nanase/japarimeter/docs/updates.md

---
layout: default
title: JapariMeter 更新履歴

header_top: false

subpages:
  - title: 頒布情報
    page: distribution
  - title: 更新履歴
    page: updates
---

# 更新履歴

## ファームウェア

<table class="spec-table">
  <tbody>
    <tr>
      <th>
        2021.03.21<br />
        <span class="foot-note">1.1.0 for Rev.1</span>
      </th>
      <td>
        <p>
          <a href="https://github.com/nanase/japarimeter/releases/tag/v1.1.0" target="_blank">ソース・ダウンロード</a>
        </p>
        <p>
          <ul>
            <li>
              不快指数の文字位置と表示画像を差し替えました。(thanks <a href="https://twitter.com/kachin397" target="_blank">@kachin397</a>)
            </li>
            <li>
              ページ切り替えボタンを素早く連続で押すと画面が乱れて表示されてしまう問題を修正しました。
            </li>
            <li>
              ボタンの効きが悪い問題を修正しました。
            </li>
            <li>
              バイナリファイルのサイズを削減しました。
            </li>
          </ul>
        </p>
      </td>
    </tr>
    <tr>
      <th>
        2021.01.01<br />
        <span class="foot-note">1.0.0 for Rev.1</span>
      </th>
      <td>
        <p>
          <a href="https://github.com/nanase/japarimeter/releases/tag/v1.0.0" target="_blank">ソース・ダウンロード</a>
        </p>
        <p>
          公開
        </p>
      </td>
    </tr>
  </tbody>
</table>

## 基板

<table class="spec-table">
  <tbody>
    <tr>
      <th>
        2021.01.01<br />
        <span class="foot-note">Rev.1</span>
      </th>
      <td>
        <div>公開</div>
        <div class="no-image-border text-center">
          <div class="inline-block">
            <a href="{{site.baseurl}}/assets/pdf/rev1_circuit.pdf" target="_blank">
              <br />
              回路図
            </a>
          </div>
          <div class="inline-block">
            <a href="{{site.baseurl}}/assets/pdf/rev1_pcb_top.pdf" target="_blank">
              <br />
              基板表面
            </a>
          </div>
          <div class="inline-block">
            <a href="{{site.baseurl}}/assets/pdf/rev1_pcb_bottom.pdf" target="_blank">
              <br />
              基板裏面
            </a>
          </div>
        </div>
      </td>
    </tr>
  </tbody>
</table>
