nanase/japarimeter/docs/assets/img/title/rev1.jpg

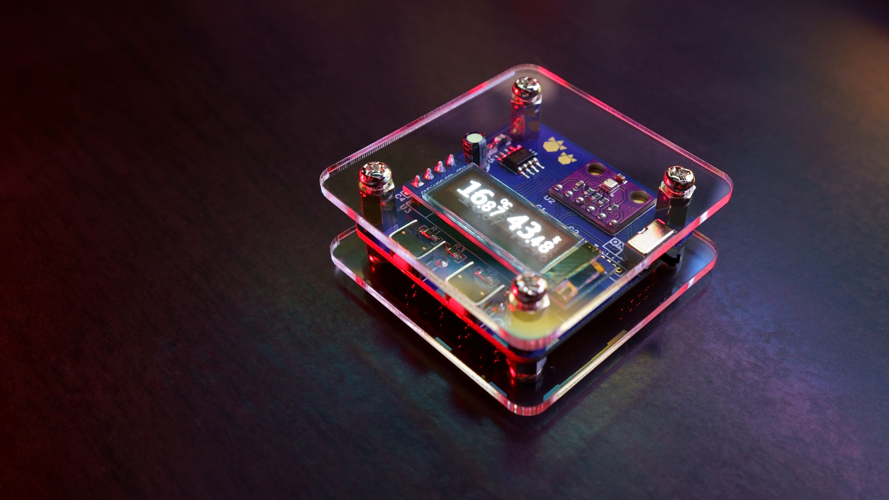
docs/assets/img/title/rev1.jpg
