nanase/japarimeter/docs/assets/pdf/rev1_parts_list.pdf

リファレンス 部品名 | 形式・値 | 型番 | 数量 | 注記 | 入手先 | 購入先リンク（参考）
| JapariMeter 基板 | | | 1
U1 | MCU | | STM32G031J6M6 | 1 | | 秋月電子 | https://akizukidenshi.com/catalog/g/gI-15688/
U2 | BME280 | 3.3V | BME280-3.3V | 1 | *1
U3 | OLED ディスプレイ | | 128x32 I2C 0.91" OLED Display | 1
B1 | ボタン電池取付用ホルダ | CR2032用 | BC-2001 | 1 | | 秋月電子 | https://akizukidenshi.com/catalog/g/gP-06925/
C1-4 | 積層セラミックコンデンサ | 1μF 2012 | EMK212BJ105KG | 4 | | 秋月電子 | https://akizukidenshi.com/catalog/g/gP-09174/
C5 | 電解コンデンサ | 10μF 16V | 16MH710MEFC4X7 | 1 | | 秋月電子 | https://akizukidenshi.com/catalog/g/gP-10591/
R1-2 | 炭素皮膜抵抗 | 10kΩ 2012 | RK73B2ATTD103J | 2 | | 千石電商 | https://www.sengoku.co.jp/mod/sgk_cart/detail.php?code=EEHD-57CE
R3-4 | 炭素皮膜抵抗 | 470Ω 1608 | RC0603J470R | 2 | *2 | 秋月電子 | https://akizukidenshi.com/catalog/g/gR-06471/
SW1-2 | 横型タクトスイッチ | | THBP07-043CW | 2 | | 秋月電子 | https://akizukidenshi.com/catalog/g/gP-14890/
SW3 | 横型スライドスイッチ | | SK-12D11VG3 | 1 | | 秋月電子 | https://akizukidenshi.com/catalog/g/gP-15703/
| 電池 | CR2032 | | 1 | | 秋月電子 | https://akizukidenshi.com/catalog/g/gB-05694/
| アクリルパネル | 45基板タイプ | LPM001T2-45 | 2 | | 秋月電子 | https://akizukidenshi.com/catalog/g/gP-12443/
| ビス | M3 | | 8
| 黄銅スペーサ | メス・メス 7mm | | 4
| 黄銅スペーサ | オス・メス 5mm | | 4

*1 5V版は取付不可。BMP280版は取り付け可能だがソフトウェア未対応
| *2 2012サイズも取付可能
