nanase/japarimeter/(threads)

Thread 1 (2021-03-21):

ボタン押下時に画面が乱れる

nanase, 2021-03-21:
## 背景

ページ送りボタンを素早く押すと画面の表示が乱れることがあり、これを修正したい。容易に再現可能。

画面の（再）描画を割り込み処理内で行っており、これが原因である可能性が高い。

## 解決方針

JapariRadio側で [`Button` クラス](https://github.com/nanase/japariradio/commit/d0f8b73d4aa98fb3d281d08c9a17077db5184c02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) を導入すると画面描画ロジックを割り込み関数から `loop` 関数に移動でき、解決できる可能性が高い。ボタン押下の判定ロジックも改良できる。

### デメリット

バイナリサイズが増加する。ただし最適化オプションを -Og から -Os に切り替え、デバッグオプションも外すと、LTOなしでもある程度は容量の余裕がある見込み。

Closed 2021-03-21.
