nanase/japarimeter/docs/assets/pdf/rev1_circuit.pdf

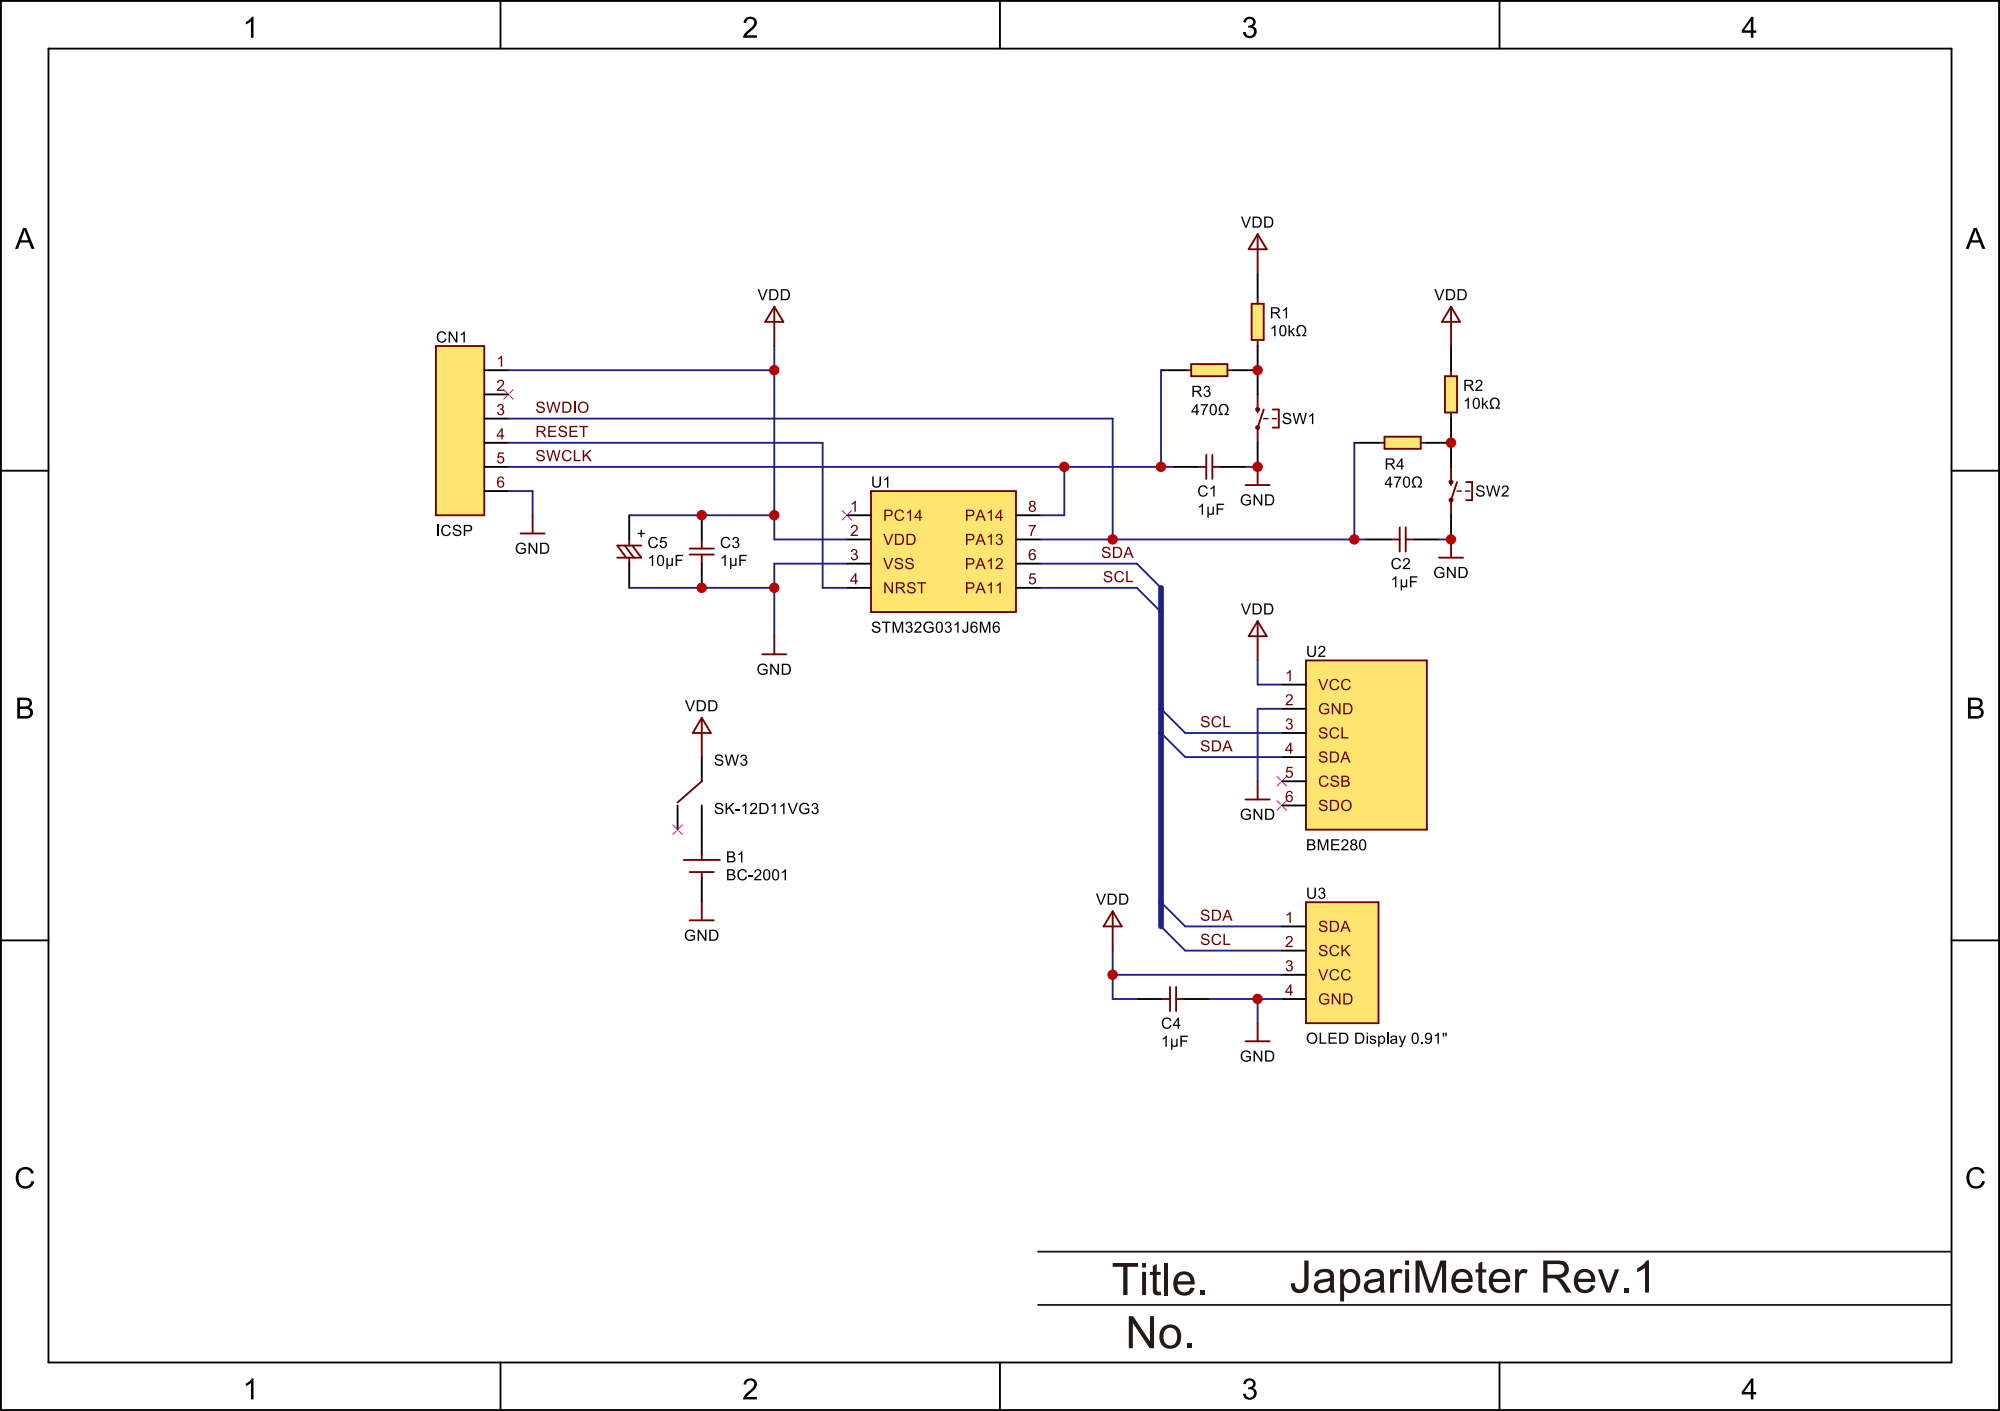
[picture p8: page 1]
