nanase/japarimeter/docs/assets/pdf/rev1_pcb_bottom.pdf

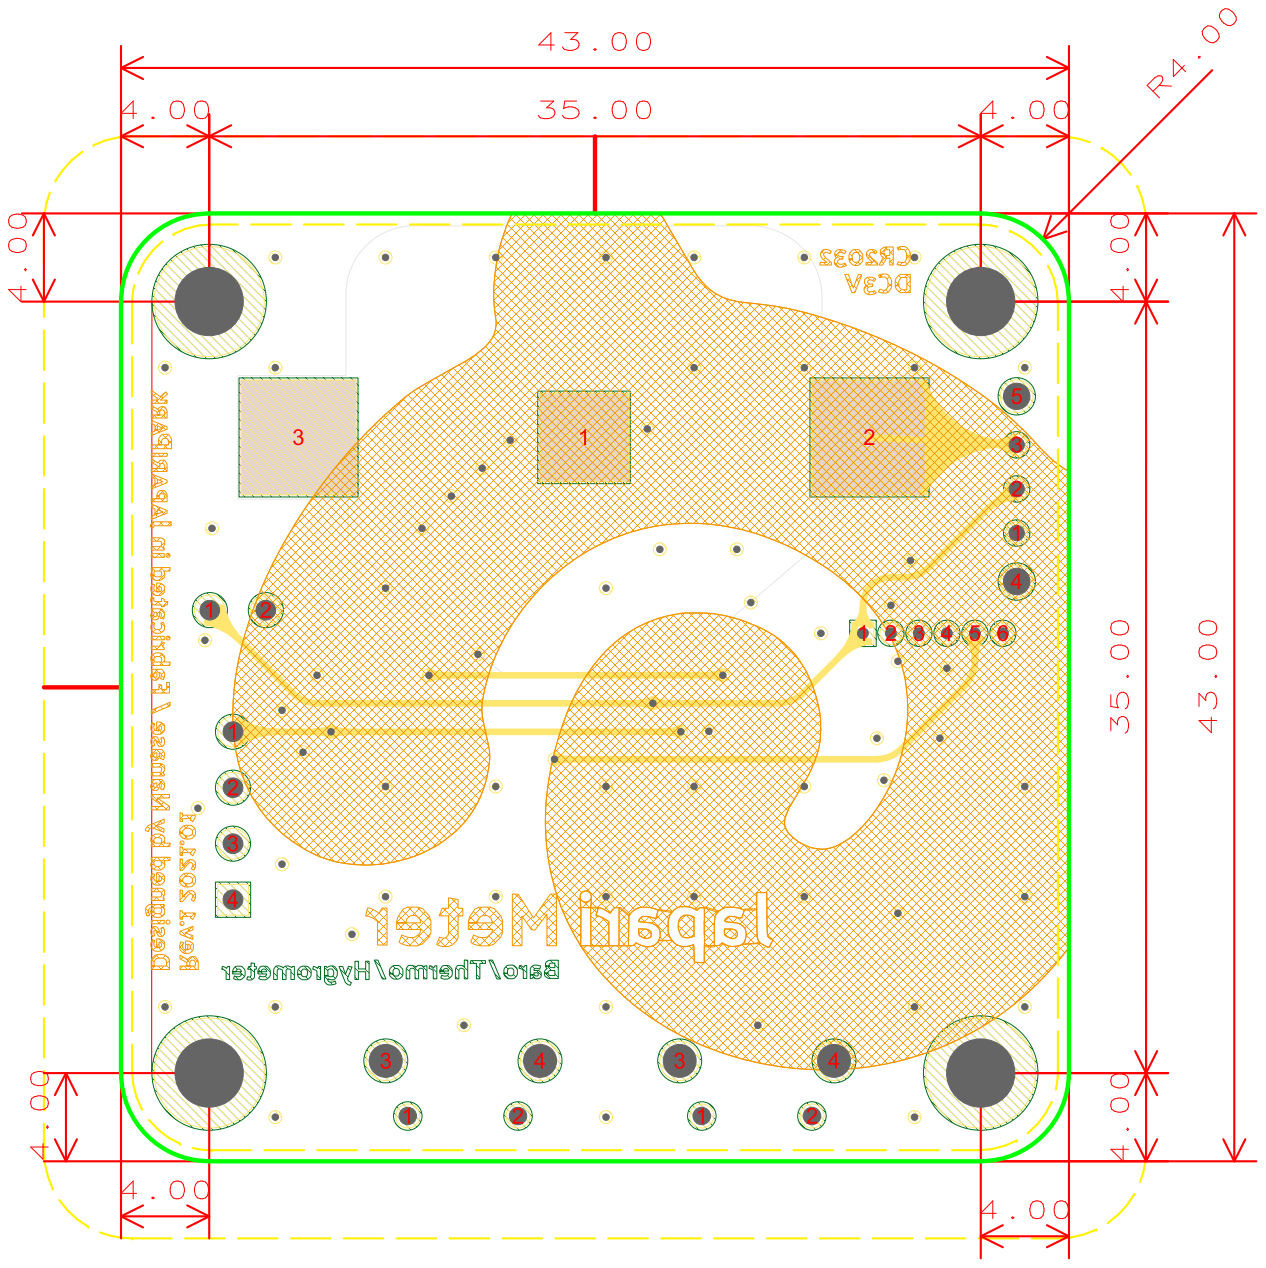
[picture p9: page 1]
