nanase/japarimeter/docs/assets/pdf/rev1_pcb_top.pdf

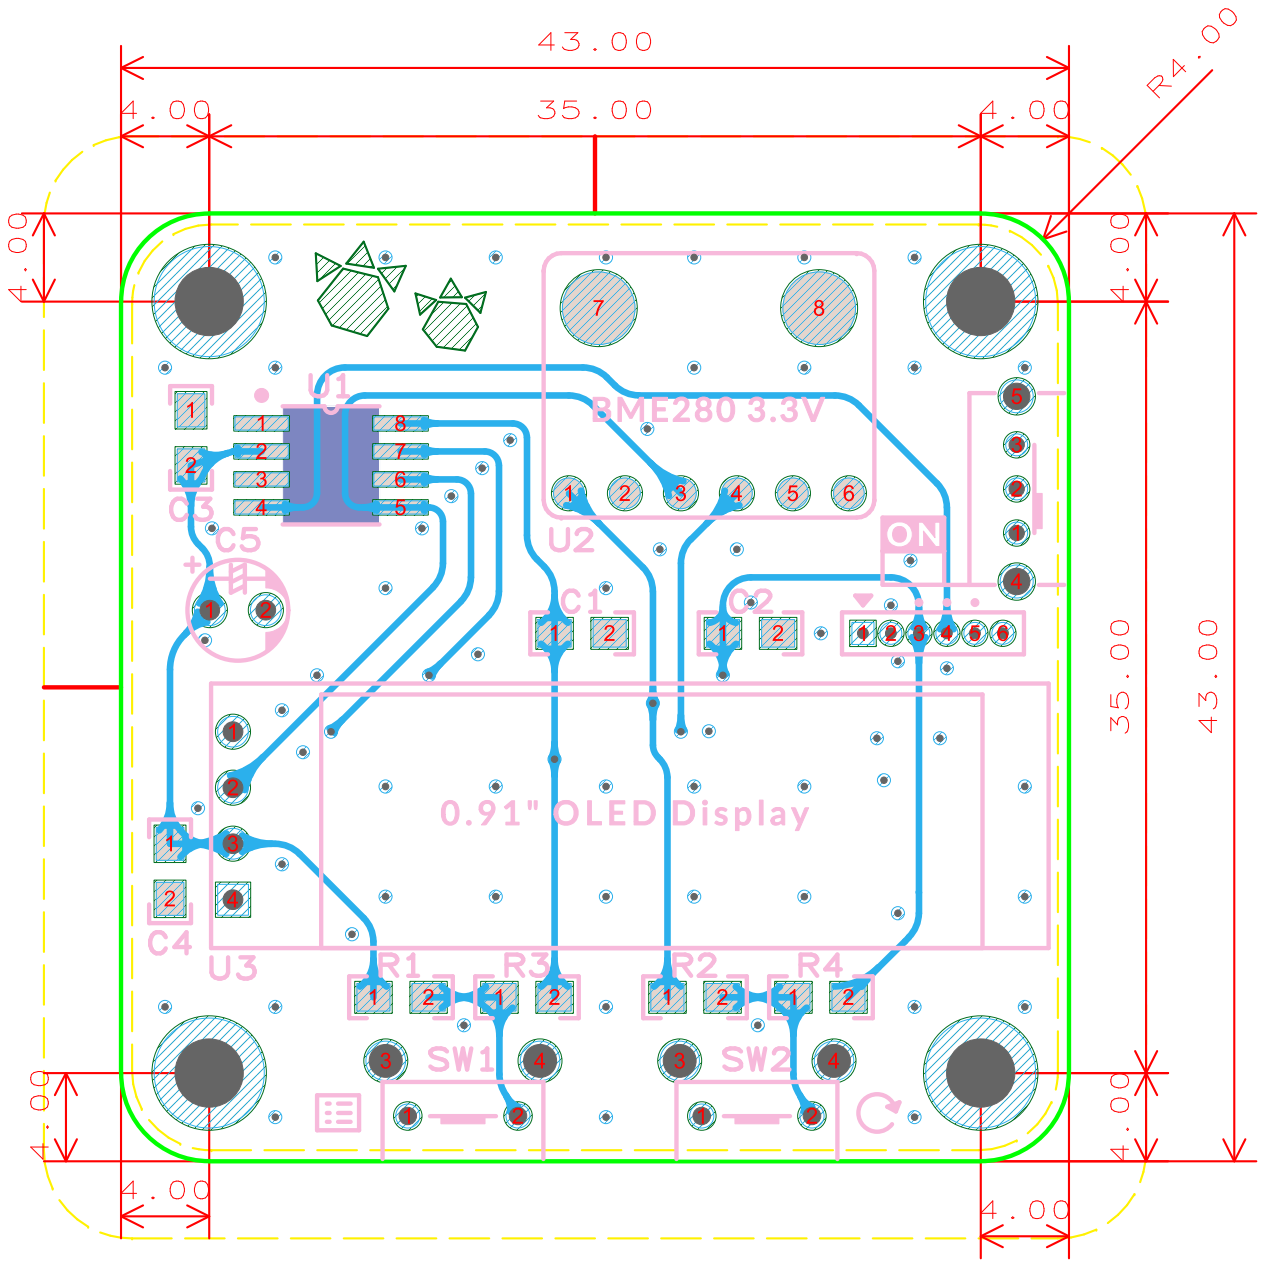
[picture p10: page 1]
