nanase/japarimeter/Inc/main.h

#define BUTTON0_Pin GPIO_PIN_0
#define BUTTON0_GPIO_Port GPIOA
#define BUTTON0_EXTI_IRQn EXTI0_IRQn
#define BUTTON1_Pin GPIO_PIN_1
#define BUTTON1_GPIO_Port GPIOA
#define BUTTON1_EXTI_IRQn EXTI1_IRQn
#define SWDIO_Pin GPIO_PIN_13
#define SWDIO_GPIO_Port GPIOA
#define SWCLK_Pin GPIO_PIN_14
#define SWCLK_GPIO_Port GPIOA
#define I2C_SCL_Pin GPIO_PIN_6
#define I2C_SCL_GPIO_Port GPIOB
#define I2C_SDA_Pin GPIO_PIN_7
#define I2C_SDA_GPIO_Port GPIOB
