nanase/japarimeter/Src/observer.c

#include "main.h"

#include "bmp280.h"
#include "ssd1306.h"
#include "fonts.h"

#include "flash.h"
#include "board_config.h"

BMP280_HandleTypedef bmp280;
char buf[32];
const uint8_t contrasts[5] = {0x01, 0x10, 0x20, 0x40, 0x8f};
uint8_t contrast_index = 4;
uint8_t page_index = 0;
float pressure, temperature, humidity;

volatile uint32_t button0_tick = 0;
volatile uint32_t button1_tick = 0;
volatile GPIO_PinState button0_state = GPIO_PIN_SET;
volatile GPIO_PinState button1_state = GPIO_PIN_SET;

extern TIM_HandleTypeDef htim6;

void HAL_TIM_PeriodElapsedCallback(TIM_HandleTypeDef *htim)
{
  if (!bmp280_read_float(&bmp280, &temperature, &pressure, &humidity))
    Error_Handler();
}

void HAL_GPIO_EXTI_Callback(uint16_t GPIO_Pin)
{
  uint32_t tick = HAL_GetTick();
  GPIO_PinState state = HAL_GPIO_ReadPin(GPIO_Pin == BUTTON0_Pin ? BUTTON0_GPIO_Port : BUTTON1_GPIO_Port, GPIO_Pin);

  if (GPIO_Pin == BUTTON0_Pin)
  {
    if (tick - button0_tick >= 200)
    {
      if (!state && page_index < 1)
        page_index++;

      button0_state = state;
    }

    button0_tick = tick;
  }

  if (GPIO_Pin == BUTTON1_Pin)
  {
    if (tick - button1_tick >= 200)
    {
      if (!state && page_index > 0)
        page_index--;

      button1_state = state;
    }

    button1_tick = tick;
  }
}

void setup()
{
  bmp280_init_default_params(&bmp280.params);
  bmp280.addr = BMP280_I2C_ADDRESS_0;
  bmp280.i2c = &hi2c1;
  // bmp280.params.mode = BMP280_MODE_NORMAL;
  bmp280.params.filter = BMP280_FILTER_OFF;
  bmp280.params.oversampling_pressure = BMP280_ULTRA_LOW_POWER;
  bmp280.params.oversampling_temperature = BMP280_ULTRA_LOW_POWER;
  bmp280.params.oversampling_humidity = BMP280_ULTRA_LOW_POWER;
  bmp280.params.standby = BMP280_STANDBY_1000;

  if (!bmp280_init(&bmp280, &bmp280.params))
  {
    Error_Handler();
  }

  HAL_TIM_Base_Start_IT(&htim6);

  ssd1306_initialize();
  ssd1306_fill(ssd1306_black);
  ssd1306_updateScreen();

  BoardConfig config;
  flash_read(31, 0, &config, sizeof(BoardConfig));

  // if (config.magic_number != 0x7F01CF42)
  // {
  //   ssd1306_setFillMode(true);
  //   ssd1306_fill(ssd1306_black);
  //   ssd1306_setCursor(5, 5);
  //   ssd1306_writeString("erase", Font_16x26, ssd1306_white);
  //   ssd1306_updateScreen();
  //   HAL_Delay(1000);

  //   flash_erase_page(31);
  //   config.magic_number = 0x7F01CF42;
  //   config.count = 0;
  //   flash_write(31, 0, &config, sizeof(BoardConfig));
  // }
  // else
  // {
  //   config.count++;
  //   flash_erase_page(31);
  //   flash_write(31, 0, &config, sizeof(BoardConfig));
  // }

  // flash_read(31, 0, &config, sizeof(BoardConfig));

  // ssd1306_setFillMode(true);
  // ssd1306_fill(ssd1306_black);
  // ssd1306_setCursor(5, 5);
  // sprintf(buf, "%d", config.count);
  // ssd1306_writeString(buf, Font_16x26, ssd1306_white);
  // ssd1306_updateScreen();
  // HAL_Delay(2000);

  ssd1306_fill(ssd1306_black);
  ssd1306_updateScreen();
}

void draw_page1()
{
  ssd1306_fill(ssd1306_black);

  ssd1306_setFillMode(true);
  ssd1306_setCursor(5, 5);
  sprintf(buf, "%2d", (int16_t)temperature);
  ssd1306_writeString(buf, Font_16x26, ssd1306_white);

  ssd1306_setCursor(39, 12);
  sprintf(buf, "%02d", (int8_t)((temperature - (int16_t)temperature) * 100));
  ssd1306_writeString(buf, Font_11x18, ssd1306_white);

  ssd1306_setFillMode(true);
  ssd1306_setCursor(52, 3);
  ssd1306_writeString("C", Font_7x10, ssd1306_white);
  ssd1306_setFillMode(false);
  ssd1306_setCursor(53, 3);
  ssd1306_writeString("C", Font_7x10, ssd1306_white);
  ssd1306_setCursor(46, 0);
  ssd1306_writeString("o", Font_7x10, ssd1306_white);

  ssd1306_setFillMode(false);
  ssd1306_setCursor(33, 13);
  ssd1306_writeString(".", Font_11x18, ssd1306_white);

  //

  ssd1306_setFillMode(true);
  ssd1306_setCursor(64 + 5, 5);
  sprintf(buf, "%2d", (uint8_t)humidity);
  ssd1306_writeString(buf, Font_16x26, ssd1306_white);

  ssd1306_setCursor(39 + 64, 12);
  sprintf(buf, "%02d", (int8_t)((humidity - (int16_t)humidity) * 100));
  ssd1306_writeString(buf, Font_11x18, ssd1306_white);

  ssd1306_setFillMode(true);
  ssd1306_setCursor(52 + 64, 3);
  ssd1306_writeString("%", Font_7x10, ssd1306_white);

  ssd1306_setFillMode(false);
  ssd1306_setCursor(33 + 64, 13);
  ssd1306_writeString(".", Font_11x18, ssd1306_white);

  ssd1306_updateScreen();
}

void draw_page2()
{
  float pressure_hpa = pressure / 100.0;

  ssd1306_fill(ssd1306_black);

  ssd1306_setFillMode(true);
  ssd1306_setCursor(37, 5);
  sprintf(buf, "%04d", (uint16_t)(pressure_hpa));
  ssd1306_writeString(buf, Font_16x26, ssd1306_white);

  ssd1306_setFillMode(true);
  ssd1306_setCursor(103, 12);
  sprintf(buf, "%02d", (int8_t)((pressure_hpa - (int16_t)pressure_hpa) * 100));
  ssd1306_writeString(buf, Font_11x18, ssd1306_white);

  ssd1306_setFillMode(true);
  ssd1306_setCursor(103, 3);
  ssd1306_writeString("hPa", Font_7x10, ssd1306_white);

  ssd1306_setFillMode(false);
  ssd1306_setCursor(97, 13);
  ssd1306_writeString(".", Font_11x18, ssd1306_white);

  ssd1306_updateScreen();
}

void loop()
{
  ssd1306_setContrast(contrasts[contrast_index]);

  switch (page_index)
  {
  case 0:
    draw_page1();
    break;

  case 1:
    draw_page2();
    break;

  default:
    break;
  }

  HAL_Delay(250);
}
