nanase/japarimeter/(commit log)

2020-12-02 startup_stm32f303x8.sをgit管理対象に追加
2020-12-02 C++でのコンパイルに変更
2020-12-08 ヘッダファイルのC++対応
2020-12-08 Page抽象クラスを導入
2020-12-08 画面切り替え前に古いPageオブジェクトを解放
2020-12-08 ライブラリファイルの移動
2020-12-08 各画面で最小限の画面描画ができるように修正
2020-12-08 起動時の画面の初回描画がされていなかった
2020-12-08 画面の初期化と更新処理を共通化
2020-12-11 BME280の取得値を整数値に変更
2020-12-11 湿度ページ追加
2020-12-11 .clang-format追加
2020-12-11 初期化時の不要な画面処理を削除
2020-12-11 フォーマッタ適用
2020-12-11 圧縮画像描画関数を追加
2020-12-11 湿度ページにアイコン追加
2020-12-11 温度ページを追加
2020-12-12 二値画像の圧縮形式を改良
2020-12-12 気圧ページに二値画像を追加
2020-12-12 ロゴ画像を追加
2020-12-14 新形式CImageを実装
2020-12-22 余分なフォルダ指定を削除
2020-12-25 PageMasterクラスを導入
2020-12-25 opening_act.cppを追加
2020-12-25 コールバック系処理をobserver.cppから分離
2020-12-25 CImageのデータ形式を変更
    幅情報を専用変数に持つことにした
2020-12-26 CFontを実装
2020-12-27 STM32G031J6用プリプロセッサを追加
2020-12-27 CImage描画処理の変数宣言を削減
2020-12-27 STM32G031J6用のフラッシュ書き込み処理へ修正
2020-12-27 STM32G031J6用の変数対応
2020-12-30 公開用サイトを追加
2020-12-31 画像差し替え
2020-12-31 テキスト修正
2020-12-31 一部ソースのディレクトリを変更
2020-12-31 フラッシュメモリ関連のソースを削除
2020-12-31 バージョン表記、不快指数、高度ページを追加
2020-12-31 未使用文字データを削除
2020-12-31 古いコードの削除
2020-12-31 ページ定義の修正
2020-12-31 画面画像を追加
2020-12-31 画面画像のテーブルを中央寄せに変更
2020-12-31 回路図へのリンクを追加
2021-01-01 ページ文言修正
2021-01-01 表ヘッダのリンク文字列を黒に変更
2021-01-01 更新情報に基板情報とファームバイナリへのリンクを追加
2021-01-01 各種表示範囲を仕様に記載
2021-01-01 高度 -> 推定高度
2021-01-02 ライセンス記載を追加
2021-01-02 部品表と組み立てマニュアルを追加
2021-01-02 写真を追加
2021-01-02 画像へのリンクを追加
2021-01-06 不快指数の文字位置を修正
2021-02-18 faviconを追加
2021-02-18 不快指数の画像を差し替え
2021-02-18 けもフレ電子工作部へのリンクを追加
2021-03-07 Makefilke修正
    - デバッグビルド解除
    - 最適化オプションを Os に変更、LTO有効化
    - ソースファイルの指定をワイルドカードに変換
    - LDFLAGSに nosys 指定、メモリ使用率を表示
    - OBJECTSの指定方法の誤りを修正
    - 不要な空白文字を削除
2021-03-21 ボタンの名前表記を廃止してA or Bに変更
    ButtonMenu -> ButtonA
    ButtonNext -> ButtonB
2021-03-21 ボタンの効きが悪く、画面が乱れる場合がある問題の修正 (close #1)
2021-03-21 バージョン表記を 1.1.0 に変更
2021-03-21 マニュアルページを1.1.0用に追記
2021-04-03 誤字修正
2021-04-03 頒布情報を更新
2021-04-03 会場の脱字修正
